har-in-air/ESP8266_BLUETOOTH_AUDIO_VARIO/docs/18650_powerbank_case.png

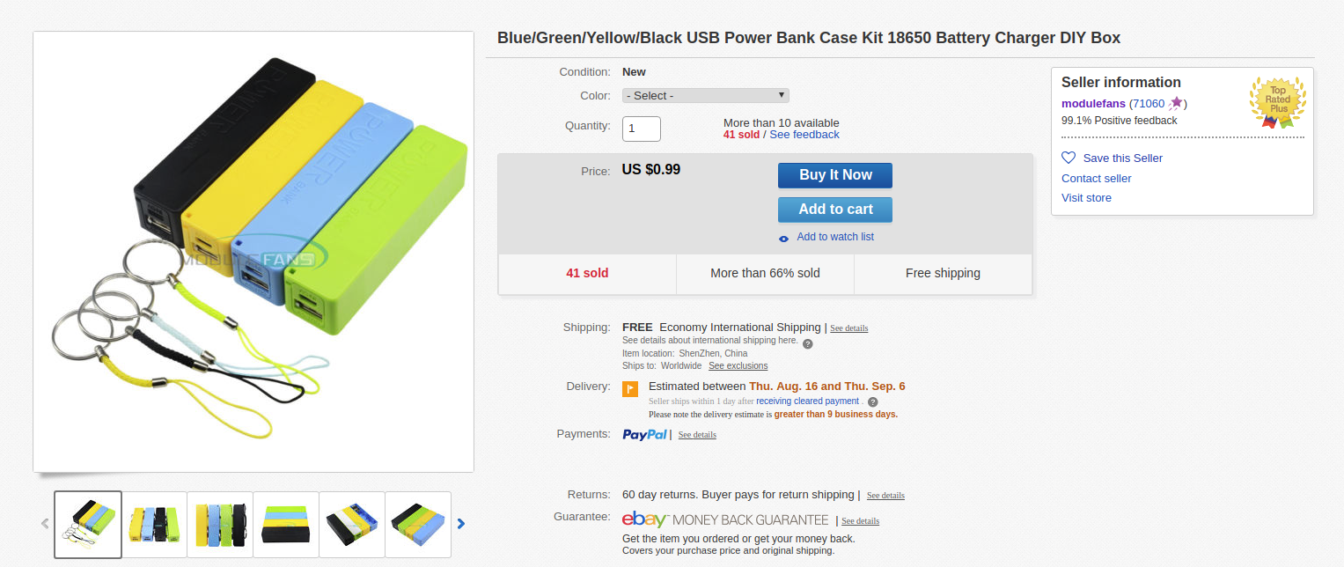
docs/18650_powerbank_case.png
