har-in-air/ESP8266_BLUETOOTH_AUDIO_VARIO/docs/smd_side_switch_ebay.png

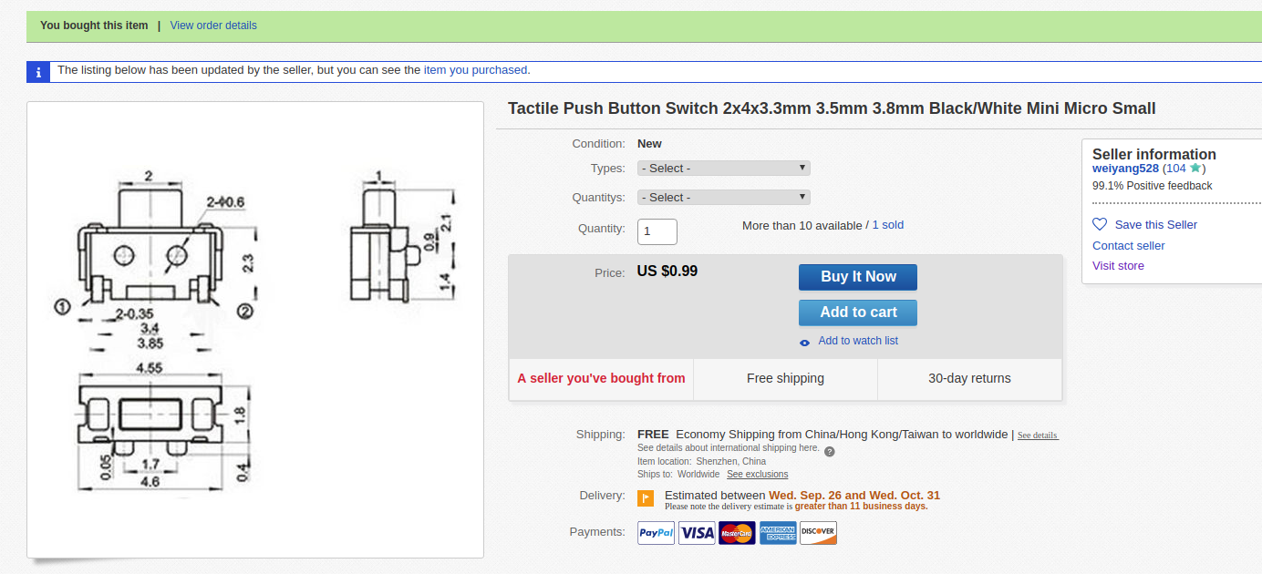
docs/smd_side_switch_ebay.png
