har-in-air/ESP8266_BLUETOOTH_AUDIO_VARIO/hw/esp8266_bluetooth_vario_schematic.pdf

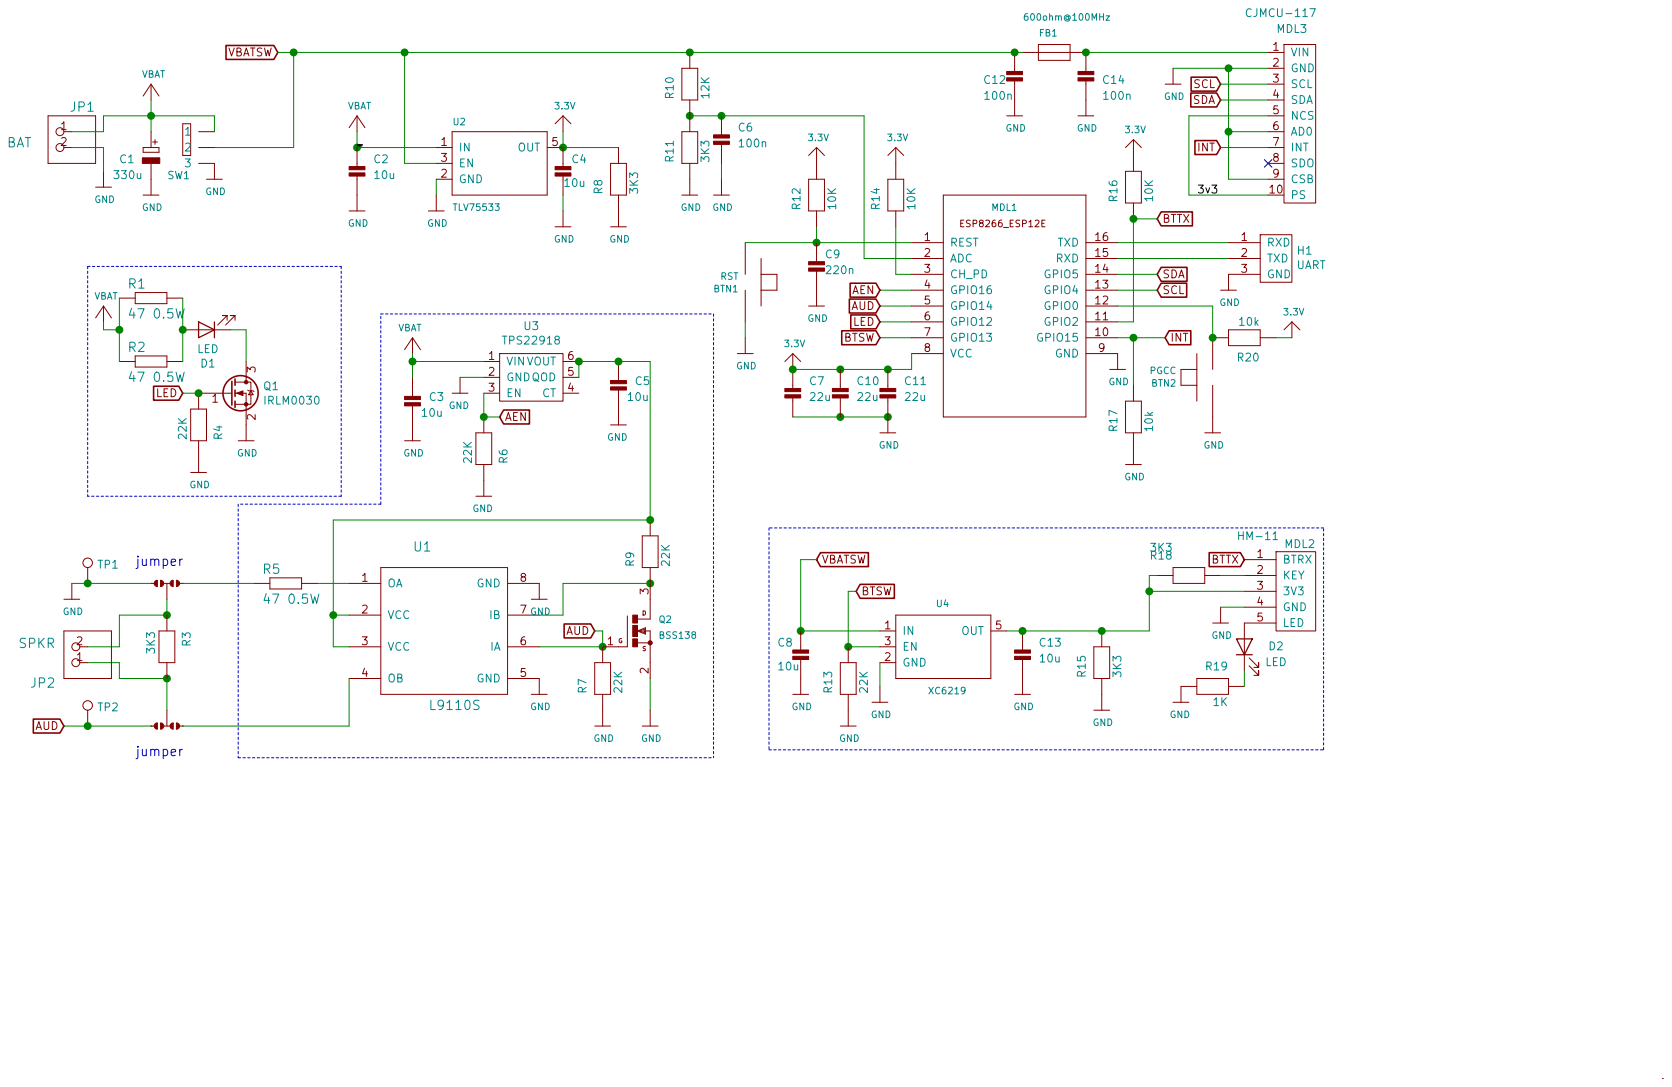
[picture p8: page 1]
