har-in-air/ESP8266_BLUETOOTH_AUDIO_VARIO/(commit log)

2018-08-05 Add files via upload
    added ss24 diode to power supply for L9110S
2018-08-05 Add files via upload
    add ss24 diode
2018-08-06 Add files via upload
    change SS24 diode to SS14
2021-12-06 fix build issues, update to KF4
    [ESP8266_BLUETOOTH_VARIO.ino, audio.cpp, util.h]
2021-12-06 adc calibrate fix
2021-12-07 calibration prompt change, fw revision fix
    [ESP8266_BLUETOOTH_VARIO.ino]
2021-12-07 calibration prompt change, update readme
2021-12-11 add kicad archive
2022-01-08 fix bluetooth config compile, use crc16 for nvd
    [ESP8266_BLUETOOTH_VARIO.ino, config.h, nvd.cpp, nvd.h, ui.cpp]
2022-01-10 wifi station support, fix button for lantern
    [ESP8266_BLUETOOTH_VARIO.ino, config.h, nvd.cpp, nvd.h, ui.cpp, wificfg.cpp]
2022-01-12 fix gyro axis typo
    [ESP8266_BLUETOOTH_VARIO.ino]
